angelomatuteest-gif/Informe-Proyecto/VISTA PERFIL ROBOT DE COMBATE.pdf

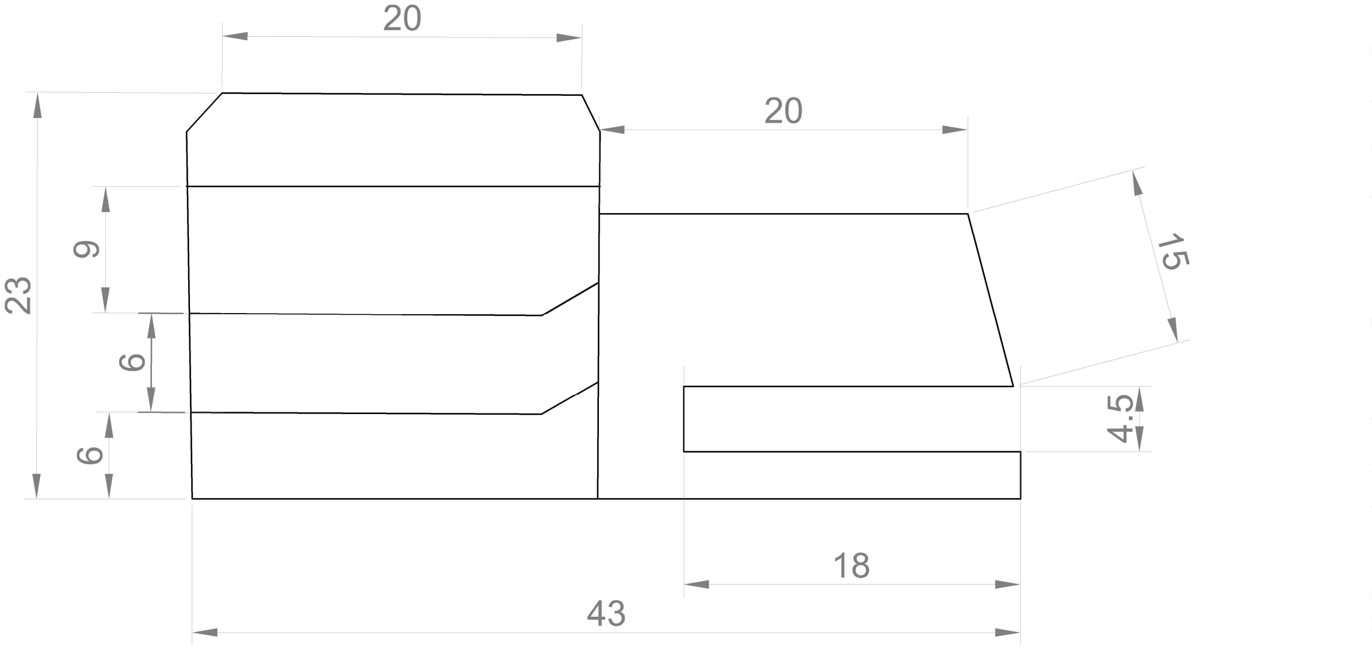
[picture p95: page 1]
