angelomatuteest-gif/Informe-Proyecto/(list of files, cad)

Other CAD files:
DiseñoMecanico.dwg
