angelomatuteest-gif/Informe-Proyecto/Chasis de robot de combate.pdf

390,00

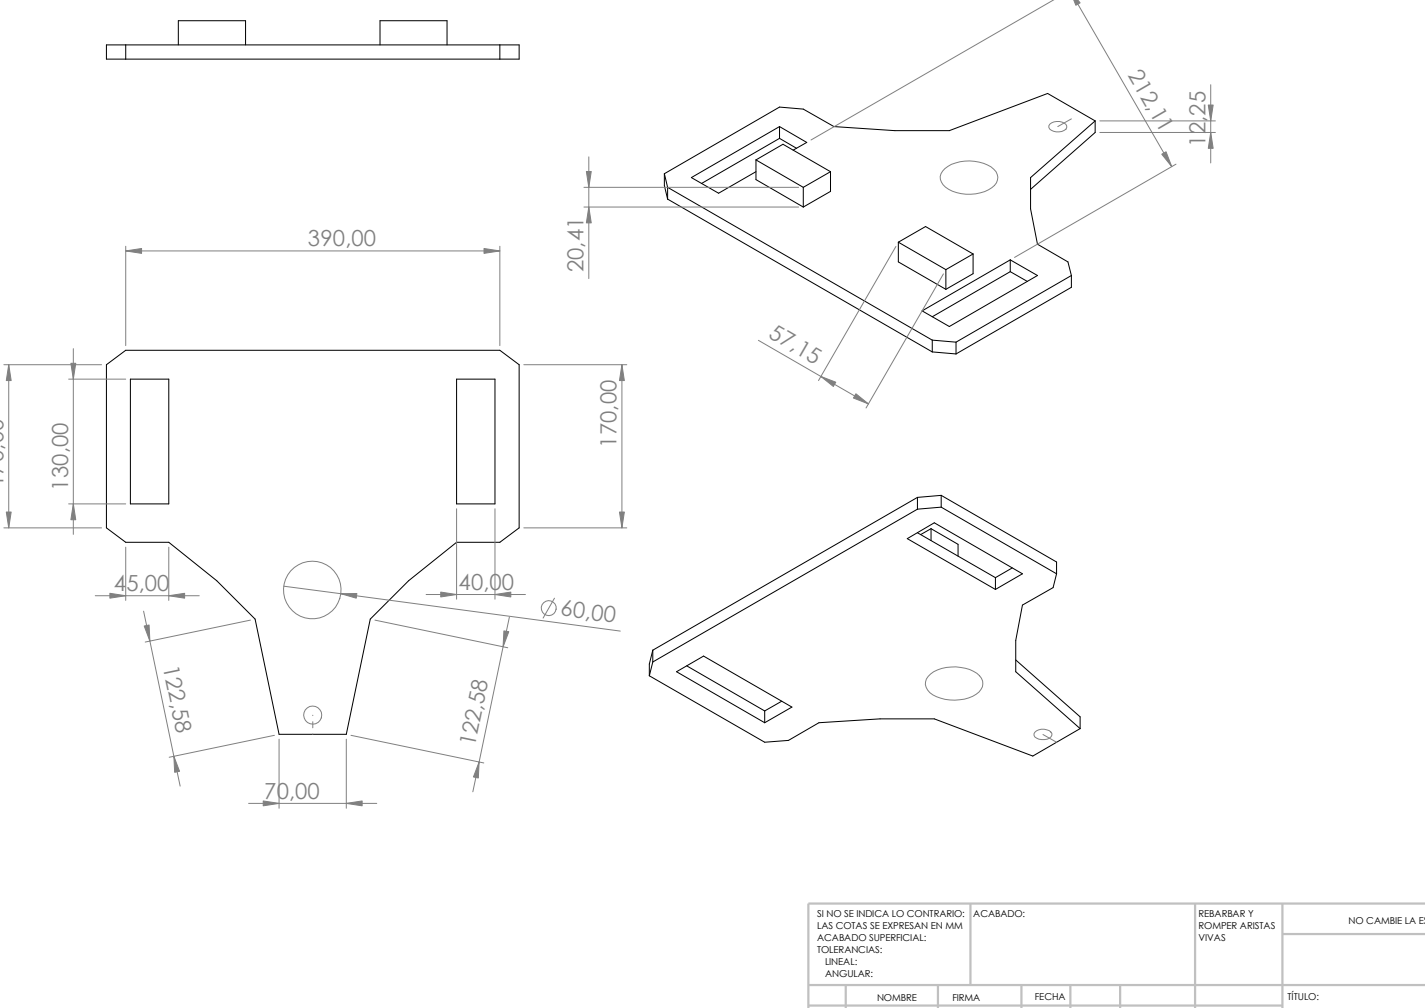
[picture p96: page 1]
TÍTULO:; ACABADO:; VIVAS; NOMBRE; FIRMA; FECHA; REBARBAR Y; ROMPER ARISTAS 170,00; 45,00 ¹³⁰,00

NO CAMBIE LA ESCALA SI NO SE INDICA LO CONTRARIO:
LAS COTAS SE EXPRESAN EN MM
ACABADO SUPERFICIAL:
TOLERANCIAS:
LINEAL:
ANGULAR:
