angelomatuteest-gif/Informe-Proyecto/(commit log)

2026-09-14 Anexo B
    Vista de perfil robot de combate con sus acotaciones a medida
2026-09-14 Chasis robot combate
    chasis robot de combate en varias perspectivas
2026-09-14 Anexo D
    Vista posterior del robot de combate
2026-09-14 informe final
    Informe final sobre el proyecto de robot de combate categoria 30 lbr llamado AJ7
